blake5634/Arduino-Yogurt-Fermentation-Controller/Readme.md

* Yogurt Fermenation Controller (Arduino)

arduino code requires LiquidCrystal_I2C-1.1.2

### CAD video:
Hardware Design CAD Video (click for youTube) (https://www.youtube.com/watch?v=vZsNuJUdTFA "CAD of Yogurt Controller Hardware")  (click to play)

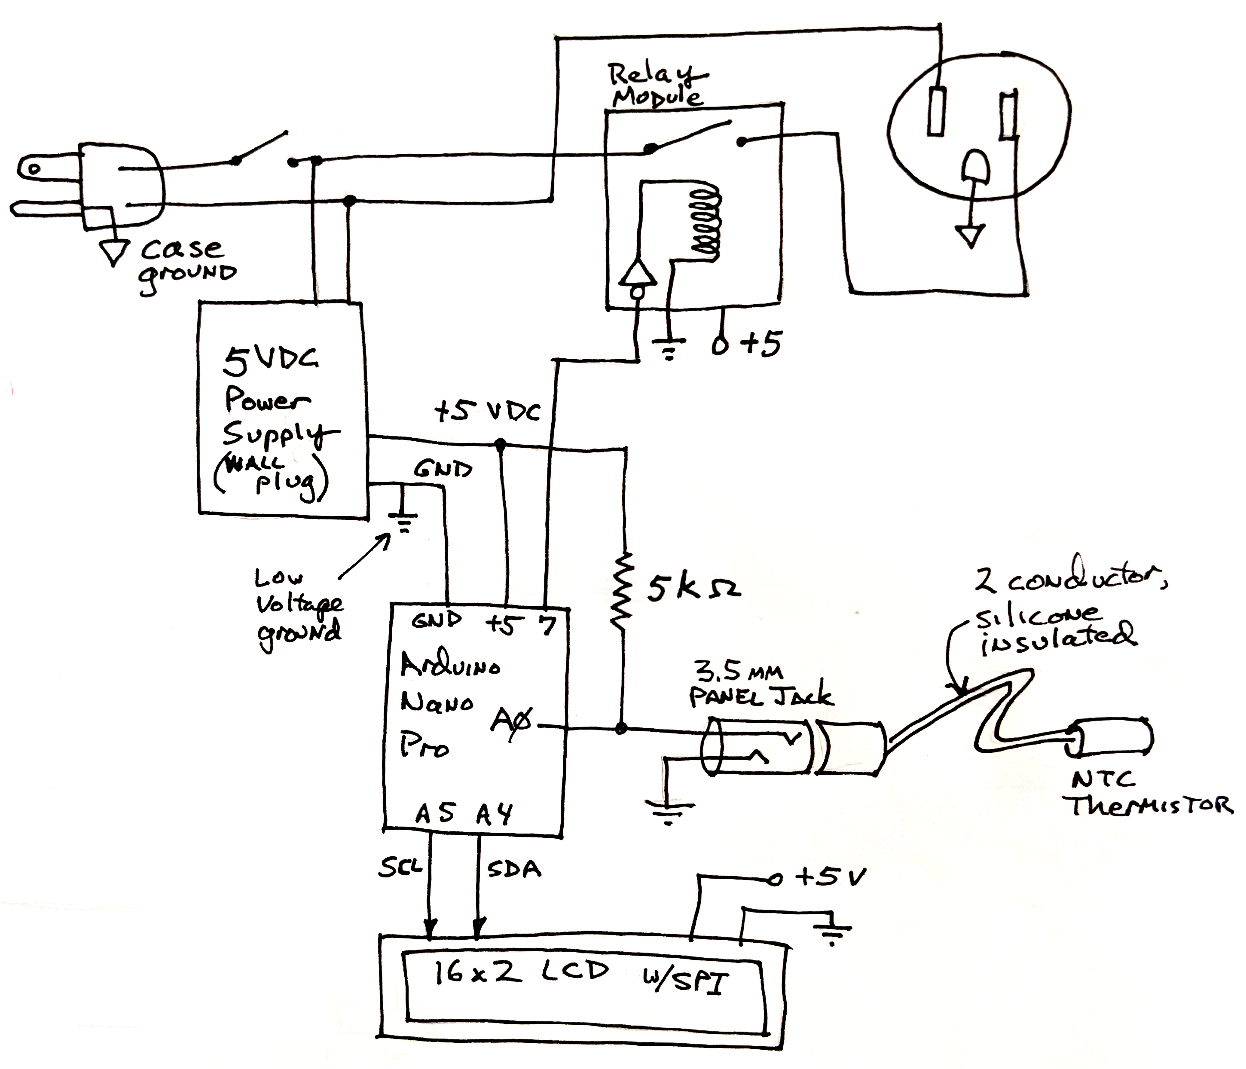
[picture p1: Hardware/yogurtControllerSchematic2023.png]
Wiring Schematic Diagram
Hardware Schematic Diagram:  

=======

* May '23

Utility
to help calibrate thermistors: CalibrationAndModels/calTemp/calTemp.ino
