blake5634/Arduino-Yogurt-Fermentation-Controller/Hardware/PCBpinouts.pdf

Yogurt Maker PCB (designed by Grace Liu, Spr 2024)

Connector Pinouts:

LCD drive: (board connector)

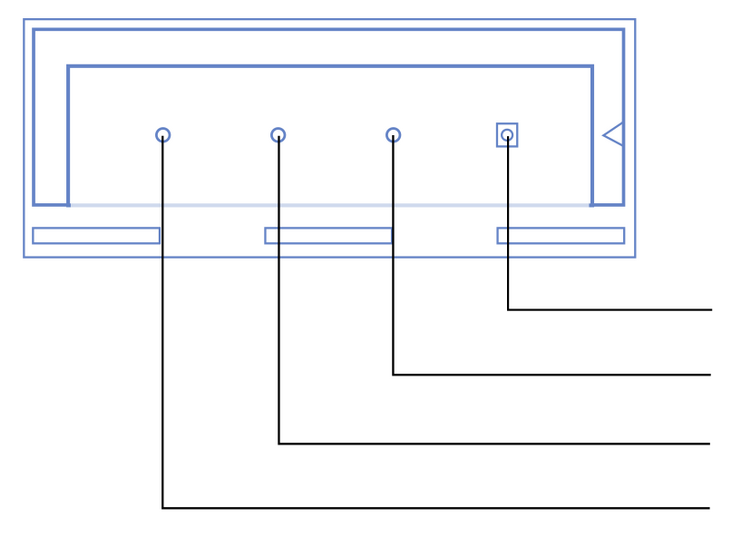
[picture p2: figure]

GND
+5V
A5 – SCL
A6 - SDA

Relay (board connector)

GND
+5V

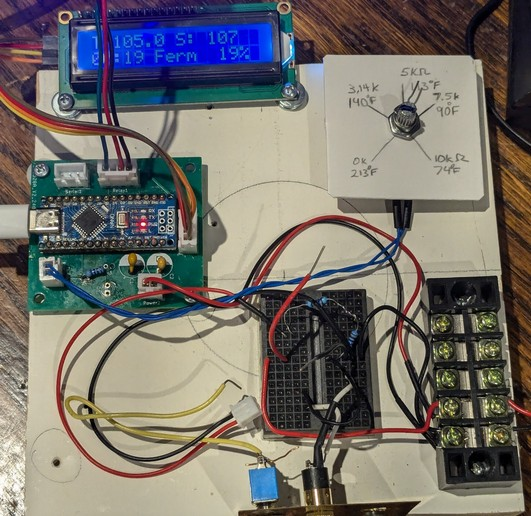
[picture p3: figure]

(not connected)
Relay Active Low

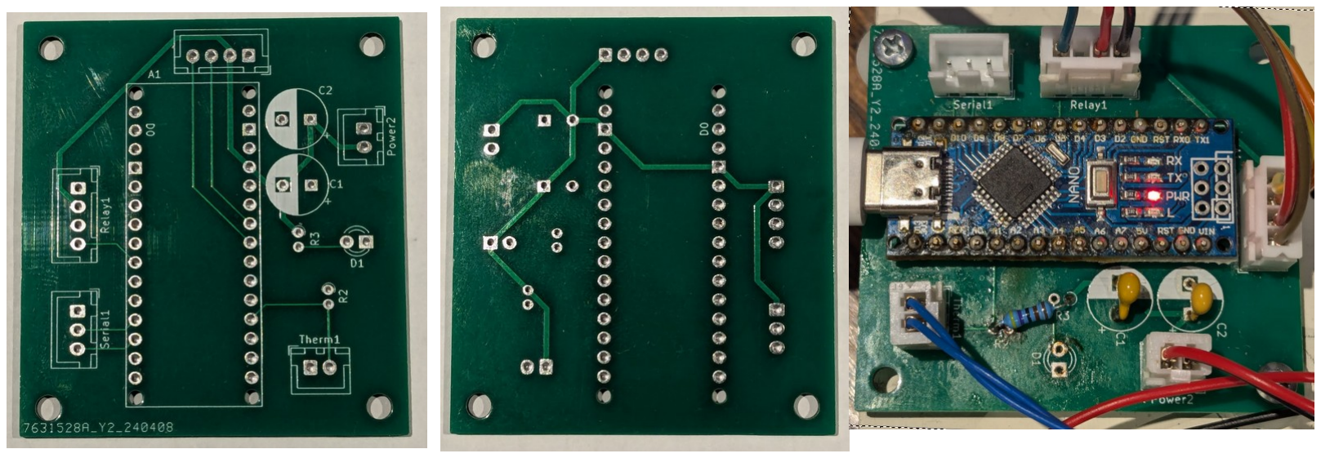
[picture p4: figure]

Relay driven by pin D6

Board Photos:
