blake5634/Arduino-Yogurt-Fermentation-Controller/arduino_code/ArduinoBoardSettings.png

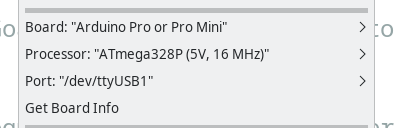
arduino_code/ArduinoBoardSettings.png
