blake5634/Arduino-Yogurt-Fermentation-Controller/Hardware/yogurtMakerEmulatorPhoto.jpg

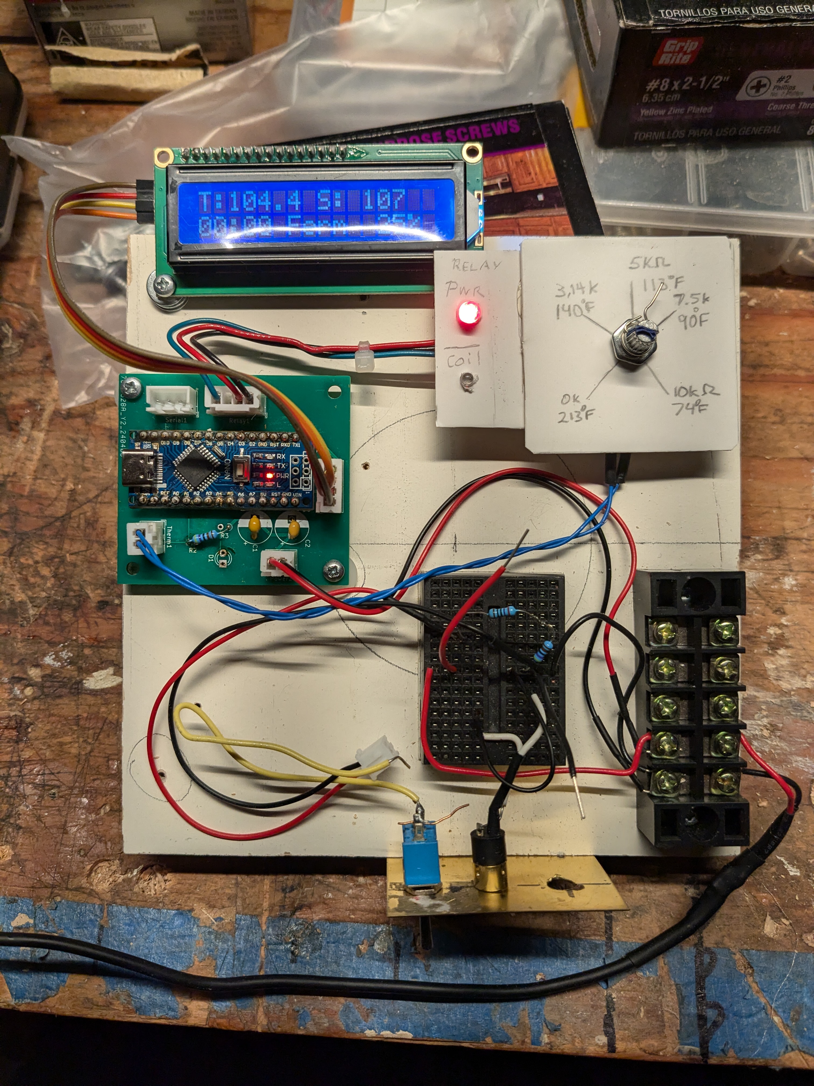
Hardware/yogurtMakerEmulatorPhoto.jpg
