blake5634/Arduino-Yogurt-Fermentation-Controller/Calibration_and_Models/VdivModel.ods

 | T=200 | T=62 | Deg/cnt
R1 | 5000.0 | 5000.0
Rth |  | 12500.0
V_adc | #VALUE! | 0.71
ADC value | #VALUE! | 146 | #VALUE!
