blake5634/Arduino-Yogurt-Fermentation-Controller/Calibration_and_Models/Simulations/milkdata.ods

07:10:00 AM | 0 | 44 | 21.1
07:23:00 AM | 13 | 53 | 17.4
07:34:00 AM | 24 | 62 | 14.1
07:46:00 AM | 36 | 71.1 | 11.2
07:56:00 AM | 46 | 81.1 | 8.7
08:06:00 AM | 56 | 92 | 7
08:18:00 AM | 68 | 102.7 | 5.5
08:38:00 AM | 88 | 121.1 | 3.74
09:04:00 AM | 114 | 138 | 2.5
09:26:00 AM | 136 | 152 | 1.85
09:47:00 AM | 157 | 165 | 1.45
10:13:00 AM | 183 | 178 | 1.14
10:34:00 AM | 204 | 184.8 | 1
10:36:00 AM | 206 | 185 | 0.985
10:58:00 AM | 228 | 178 | 1.16
11:26:00 AM | 256 | 166 | 1.46
12:05:00 PM | 295 | 153 | 1.89
12:28:00 PM | 318 | 145.8 | 2.17
12:52:00 PM | 342 | 140 | 2.43
