blake5634/Arduino-Yogurt-Fermentation-Controller/(commit log)

2023-04-23 Uses EEPROM to start at last state prior to power off
2023-04-27 smooth working with very low SSE but too much clicking
    [test_yog_ctl.ino]
2023-04-27 ready to test with improved PID AND EEPROM state storage
2023-04-27 found the statechange bug
    [yogurt_control.ino]
2023-04-28 uploaded version prior to hardware failure
    [yogurt_control.ino]
2023-04-28 correct incorrect setpoint display
    [yogurt_control.ino]
2023-05-01 adding a ramping correction above Tferment
    [yogurt_control.ino]
2023-05-01 added schematic diagram
2023-05-07 syntax error and comments
    [yogurt_control.ino]
2023-05-09 new code for easy calibration: calTemp.ino
2023-05-10 point out location of new calibrator tool
2023-05-10 correct location and name of calTemp.ino
    [calTemp.ino]
2023-05-10 resolved clock speed/build settings and ran t calibration
    [calData10-May-23_WHITE.csv, calData10-May-23_WHITE.ods]
2023-05-11 update calbration study
    [calData10-May-23_WHITE.csv, calData10-May-23_WHITE.ods]
2023-11-24 New test for thermistor cable assy.
2023-11-25 new calib data w/ therm calib app
    [calData24-Nov-23_WHITE.csv, calData24-Nov-23_WHITE.ods]
2024-08-05 hardware info for controller PCB
2024-08-05 change relay drive pins
